lucasandrdo/DAPA-TCC/documentacao/prototipo/modulo-porta.png

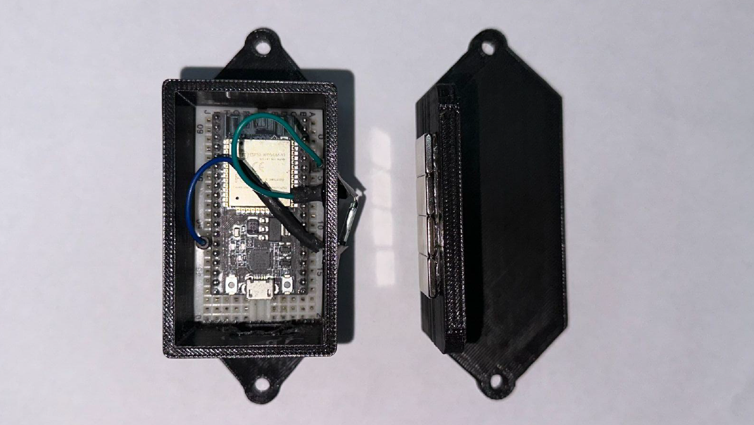
documentacao/prototipo/modulo-porta.png
