lucasandrdo/DAPA-TCC/documentacao/prototipo/modulo-controle.png

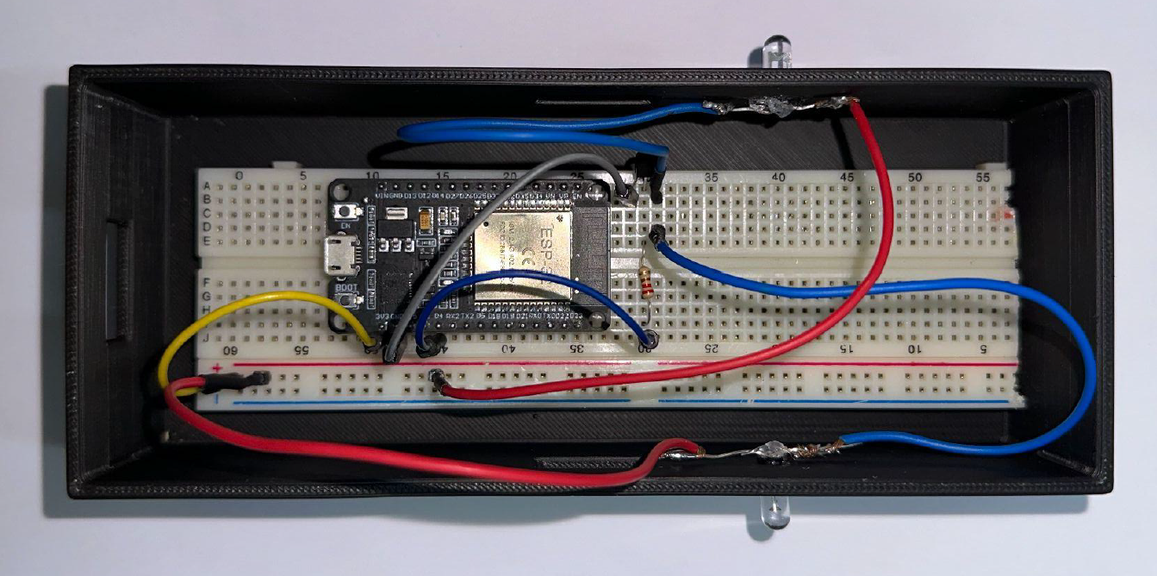
documentacao/prototipo/modulo-controle.png
