lucasandrdo/DAPA-TCC/documentacao/arquitetura/arquitetura-sistema.png

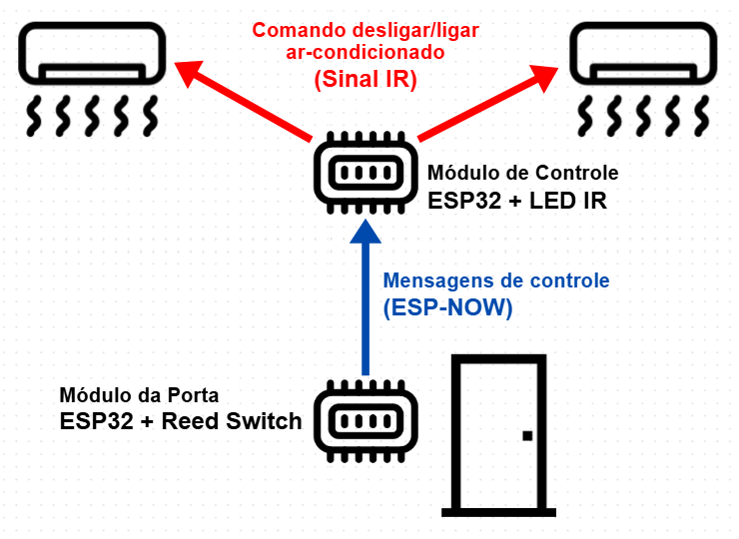
documentacao/arquitetura/arquitetura-sistema.png
